aUtopiaWithoutChemistry/IoRacket/hardware/cad/fit_gauge.stl

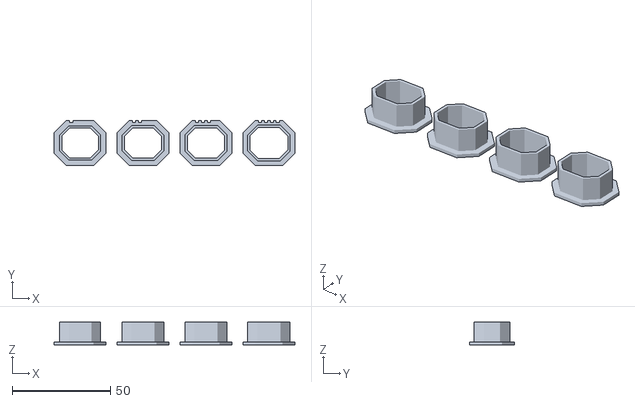
[picture p8: CAD file, 2026-10-30]
hardware/cad/fit_gauge.stl
122.5 x 23.0 x 11.5
