aUtopiaWithoutChemistry/IoRacket/hardware/cad/endcap_v3.stl

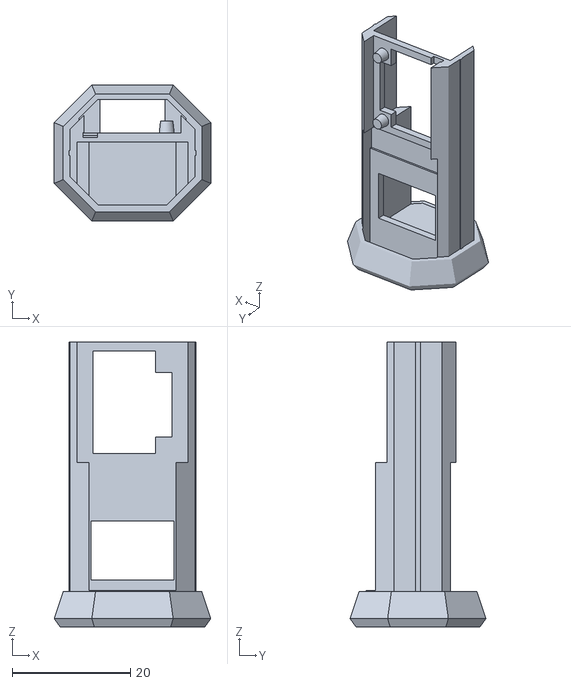
[picture p9: CAD file, 2026-10-30]
hardware/cad/endcap_v3.stl
26.6 x 23.1 x 48.3
