aUtopiaWithoutChemistry/IoRacket/(commit log)

2026-01-24 added IoRacket on esp32 project
2026-01-24 Update main.cpp
    delete testing code for checking sensor
2026-01-25 Update main.py
    added function of tracking real-time data and visualize the acc on x axis
2026-10-30 WIP: BLEManager/visualizer split and imu_test bring-up example
    Snapshot of uncommitted work from Jan 2026 before repo reorganization.
    Claude-Session: https://claude.ai/code/session_01EiqtDzqbzt7HLvMHHS74Rv
2026-10-30 Reorganize repo for XIAO ESP32-S3 hardware
    - Rename IoRacket/ -> firmware/, IoRacket-data/ -> host/, add hardware/
    - Target seeed_xiao_esp32s3; I2C on D4/D5 (GPIO5/6) via IMU_SDA/IMU_SCL
    - Add end cap v3 + fit gauge STLs and hardware build notes
    - Add PySide6 to host requirements; ignore sliced gcode, venv, local archive
    - Add CLAUDE.md with hardware context, known issues and next steps
    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
    [endcap_v3.stl, fit_gauge.stl]
2026-10-30 Add v2 firmware test examples: FIFO sampling, BLE streaming, BLE bootloader
    - fifo_test: MPU6050 FIFO at 1 kHz via raw registers (+/-16 g, +/-2000 dps,
    DLPF 260 Hz, I2C 400 kHz), with I2C bus recovery for an IMU left holding
    SDA low after an MCU reset mid-read.
    - ble_stream: streams v2 packets (uint32 index, n, ranges, n x 12 B raw
    samples; packet size follows the negotiated MTU) with serial diagnostics.
    Resets the CCCD on disconnect so a reconnect does not start streaming
    before the host subscribes.
    - bl_test + host/enter_bootloader.py: reboot into download mode over BLE
    (BLE side works; esptool cannot sync afterwards yet).
    - platformio.ini: new envs; watchdog reset after upload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
    [main.cpp]
2026-10-30 Rewrite host receiver UI for the v2 BLE packet format
    - data_parser: decode/encode v2 packets, raw int16 to g / dps, saturation count.
    - ble_manager: Bleak on a background asyncio thread, packets to the UI via Qt signals.
    - simulator: simulated racket (fake swings that saturate, ~0.5% dropped packets).
    - visualizer: connect/disconnect, live 5 s acc and gyro plots, sample rate,
    lost packets, saturated samples, kB/s, CSV recording of raw int16 data.
    - main.py: startup only (fixes the old ImportError).
2026-10-30 Firmware v2: stream raw 1 kHz IMU data over BLE from the main firmware
    - SensorManager: MPU6050 FIFO at 1 kHz via raw registers (+/-16 g,
    +/-2000 dps, DLPF 260 Hz, I2C 400 kHz), I2C bus recovery, sleep/wake.
    - BLEManager: v2 data characteristic (packet size follows the MTU),
    control characteristic (0x01 = reboot into download mode), slow
    advertising, CCCD reset on disconnect so reconnects work.
    - main: streaming starts when the host subscribes and stops (IMU asleep)
    when it unsubscribes; on FIFO overflow the sample index skips the lost
    samples so the host sees them as a gap.
    - Serial TX timeout 1 ms: 0 makes the core's write loop wrap its retry
    counter and block until USB returns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
    [BLEManager.cpp, BLEManager.h, SensorManager.cpp, SensorManager.h, main.cpp]
2026-10-31 Host app: six-axis live view, replay window, video sync with slow motion
    - Live view: one plot per axis (acc left, gyro right), y fixed to the
    sensor range with limit lines, saturated samples marked, autoscale.
    - Recording: on stop, name the file (<name>_<date_time>.csv) and add a
    note written into the CSV header.
    - Replay window: session overview with detected swings and sync taps,
    swing list (peak deg/s, g, head speed in km/h, clipping marked as
    lower bounds), single-swing 6-axis view, swings overlaid at the peak.
    - Analysis: gyro bias from still periods, swing segmentation, head speed
    from rotation (IMU Y = handle axis, 635 mm to the head), tap detection
    that ignores the brief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
2026-10-31 Bilingual (English / Chinese) host UI, English-only README
    - All UI text is English first with Chinese alongside: short labels as
    "English / 中文", two-line table headers, two-line dialog messages.
    - Video controls: seek bar on its own row (it was squeezed by the longer
    button labels); wider sync and save dialogs.
    - README: button names in English.
2026-10-31 Fix "Link video" button raising TypeError on every click
    QPushButton.clicked passes a "checked" argument, and a no-argument Qt
    signal's emit() cannot drop it the way plain Python slots can.
2026-10-31 added more hardware and assemble detail&images
2026-11-01 Tap detection rev 4, English-only UI, v2 roadmap
    - find_taps: require the impact to stop the racket's rotation instead of
    limiting the spike to 40 ms (the swing into the palm can itself reach
    ~2.4 g, so the start tap of 10-31-test1 was missed)
    - remove the Chinese half of every UI string
    - README roadmap: v2 = LSM6DSV320X PCBA + live Continuity Camera recording
